SuperBoots/CondensationPump/WiringImages/PXL_20220805_065648915.jpg

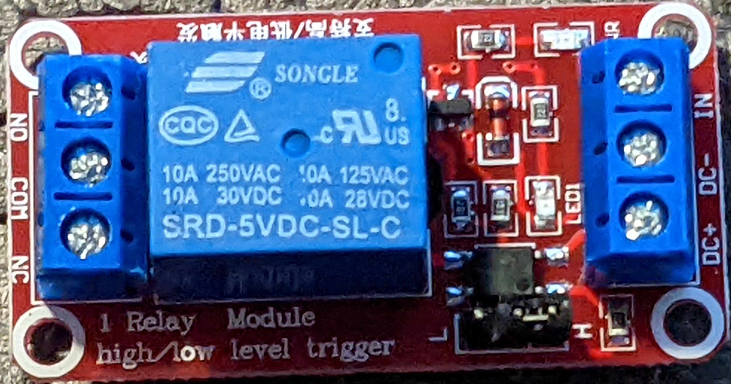
WiringImages/PXL_20220805_065648915.jpg
