SuperBoots/CondensationPump/WiringImages/development_boards_5vpinout.jpg

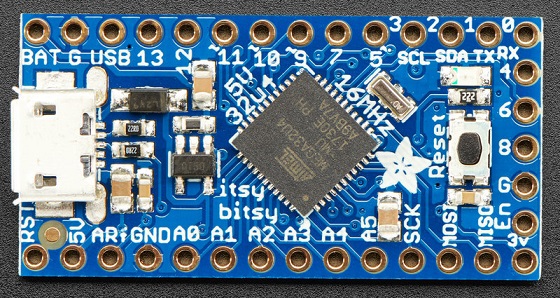
WiringImages/development_boards_5vpinout.jpg
