SuperBoots/CondensationPump/WiringImages/51vaj61j8kL._AC_SL1200_.jpg

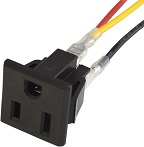
WiringImages/51vaj61j8kL._AC_SL1200_.jpg
