SuperBoots/CondensationPump/WiringImages/51ybVt5TJWL._AC_SL1000_.jpg

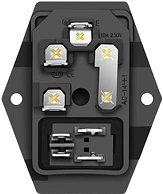
WiringImages/51ybVt5TJWL._AC_SL1000_.jpg
