SuperBoots/CondensationPump/WiringImages/501-05.jpg

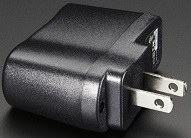
WiringImages/501-05.jpg
