SuperBoots/CondensationPump/WiringImages/CondensationPumpDiagram.jpg

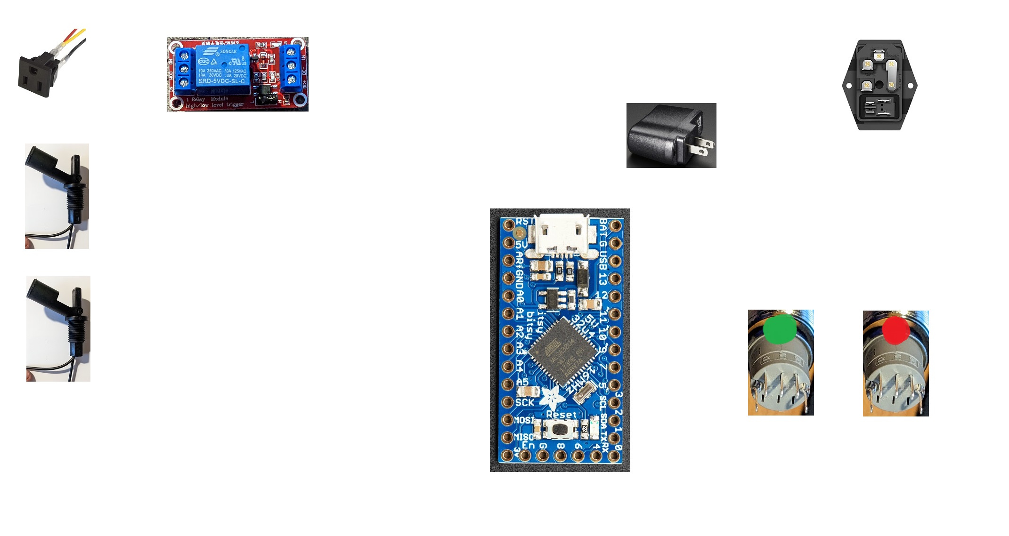
WiringImages/CondensationPumpDiagram.jpg
