SuperBoots/CondensationPump/WiringImages/CondensationPumpDiagram_v0-1.jpg

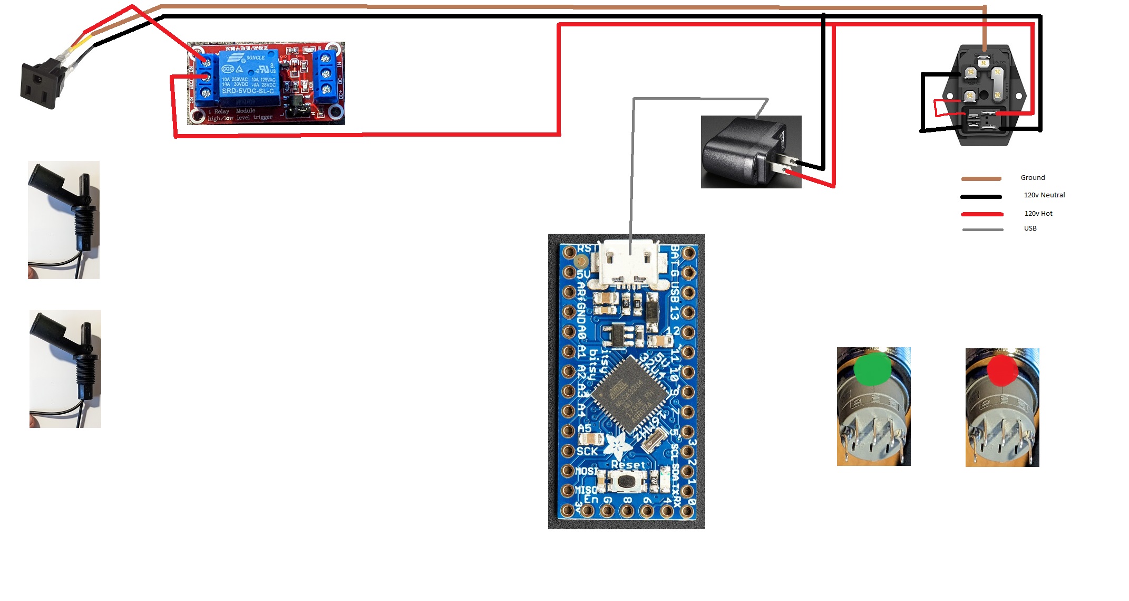
WiringImages/CondensationPumpDiagram_v0-1.jpg
