SuperBoots/CondensationPump/WiringImages/CondensationPumpDiagram_v0-2.jpg

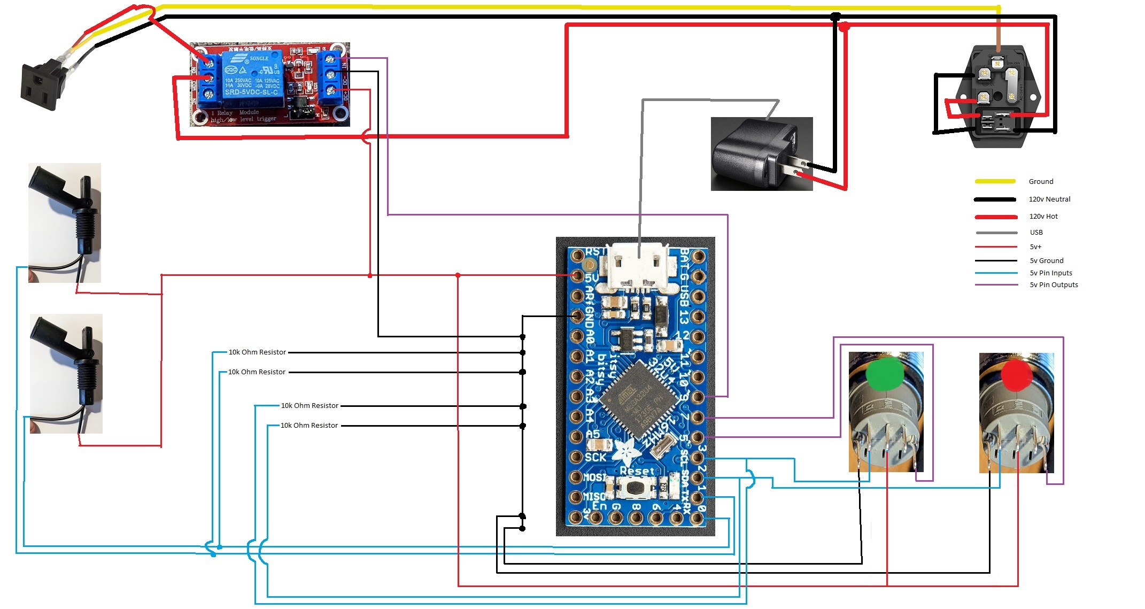
WiringImages/CondensationPumpDiagram_v0-2.jpg
