SuperBoots/CondensationPump/WiringImages/original_3ae8b2b8-414e-4383-a3de-4cd817d58724_PXL_20220805_070410684.MP.jpg

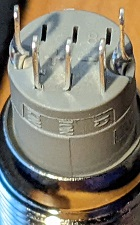
WiringImages/original_3ae8b2b8-414e-4383-a3de-4cd817d58724_PXL_20220805_070410684.MP.jpg
