SuperBoots/CondensationPump/WiringImages/PXL_20220805_070816433.MP.jpg

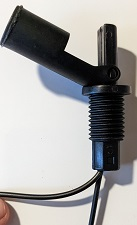
WiringImages/PXL_20220805_070816433.MP.jpg
