SuperBoots/CondensationPump/(commit log)

2022-08-05 Update CondensationPump.ino
    demo LED flash program
2022-08-05 Update CondensationPump.ino
    adding pin definitions
2022-08-06 Update CondensationPump.ino
    prototype with everything connected, just testing basic connections
2022-08-08 Update CondensationPump.ino
    reversing float logic
    [CondensationPump.ino]
2022-08-10 Update CondensationPump.ino
    Adding error mode which stops pump and flashes red LED if in auto mode and pump has been running longer than 20 seconds. This should save the pump if it falls over or something.
    [CondensationPump.ino]
2022-08-11 Adding green flash pump run count
    Adding feature where when in auto mode the green LED will flash the number of times the pump has been run since powered on
2022-08-12 Update CondensationPump.ino
    updating auto pump count to flash the number of auto pumps and then wait 10 seconds before repeating
